Konsolkongen/PC-Engine-mini-rapid-fire-mod/pictures/insides2.jpg

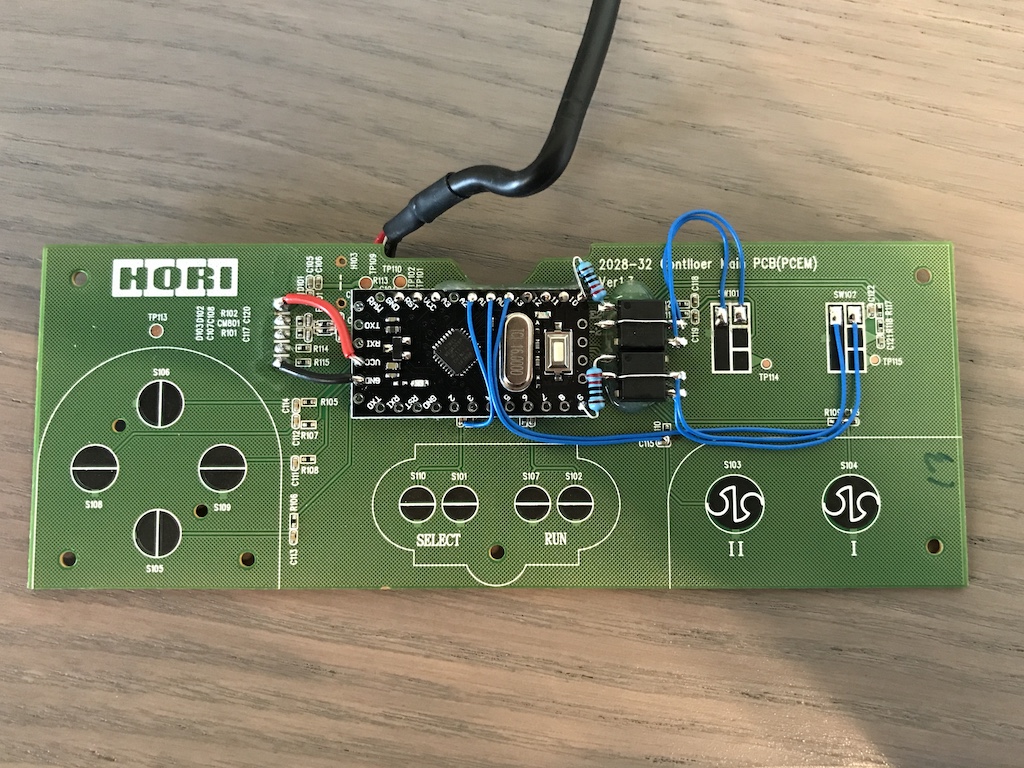
pictures/insides2.jpg
